oprobst/OvenController/specs/002-controller-pcb/contracts/connectors.md

# Contracts: Steckverbinder, Pinbelegung und Testpunkte (REV A)

Hardware-Schnittstelle zwischen Platine, Lastteil, Bedienteil und Gehäuse (Prinzip VI). Jede
Änderung hier muss in Firmware (`board_rev_a.h`), KiCad-Projekt und Doku nachgezogen werden.
Pin 1 ist auf der Platine markiert.

## J1 – Netz (230 V)

Feste Schraubklemme 2-polig, Raster 5,08 mm (Phoenix MKDS 1,5/2-5,08, Footprint
`oven:Phoenix_MKDS-1,5-2-5.08_Horizontal_OvalPads`). Nur im Netzbereich, Beschriftung „230 V~".

| Pin | Signal |
|---|---|
| 1 | L (nach Hauptschalter und Gerätesicherung der Kaltgerätebuchse) |
| 2 | N |

Kein PE an der Platine. Zuleitung: Mantelleitung H05VV-F 2 × 0,75 mm² durch die Durchführung der
Netzabdeckung (Mantel endet ≥ 5 mm innen, Zugentlastung an der Unterschale); die Klemme
liegt ganz unter der Abdeckung und wird bei offener Abdeckung angeklemmt ([research.md R19](../research.md#r19--netzabdeckung-fr-039-sc-010)).

## J2 – Lastteil (Kleinspannung)

Feste Schraubklemme 6-polig, Raster 3,81 mm (Phoenix MKDS 1/6-3,81, Footprint
`oven:Phoenix_MKDS-1-6-3.81_Horizontal_OvalPads`); Drahteinführung zur Platinenkante.

| Pin | Signal | Gegenstelle |
|---|---|---|
| 1 | +5V_SSR (geschaltet durch Freigabe) | „+" beider SSR-Eingänge |
| 2 | SSR_TOP− | „−" SSR Oberhitze |
| 3 | SSR_BOT− | „−" SSR Unterhitze |
| 4 | +5V (dauernd) | Relaisspule A1 |
| 5 | RELAY− | Relaisspule A2 |
| 6 | GND | Reserve / Schirm |

## J3 – Debug-UART (optional bestückt)

Pinleiste 3-polig: 1 GND, 2 TX (GPIO 43), 3 RX (GPIO 44).

## J4 – Encoder (Encoder-Träger)

JST XH 1×5, Raster 2,5 mm, stehend (B5B-XH-A). Gegenstück gleicher Belegung auf dem Encoder-Träger
(Kabel 1:1). Die Reihenfolge folgt den Anschlüssen des Encoders (A, C, B, S1, S2).

| Pin | Signal | Encoder |
|---|---|---|
| 1 | ENC_A | A |
| 2 | GND | C (gemeinsam) |
| 3 | ENC_B | B |
| 4 | ENC_SW | S1 (Taster) |
| 5 | GND | S2 (Taster) |

Auf dem Encoder-Träger (`hardware/encoder-carrier`): J1 = JST XH 1×5 mit derselben Belegung,
SW1 = Alps EC11E15244G1.

## J5 – Stopp-Taste

JST XH 1×4, Raster 2,5 mm, stehend (B4B-XH-A); die Litzen der Stopp-Taste gehen direkt an die
Hauptplatine (nicht mehr über den Encoder-Träger). Andere Polzahl als J4, damit die Stecker nicht
vertauscht werden können. Ist der Stecker abgezogen, ist der Öffner-Kreis offen und die
Löschleitung aktiv: Ein fehlender Stecker wirkt wie eine gedrückte Stopp-Taste.

| Pin | Signal | Kontakt |
|---|---|---|
| 1 | STOP_NC_OUT (3,3 V zum Öffner) | Öffner, Seite 1 |
| 2 | STOP_NC_RET (vom Öffner zur Löschleitung) | Öffner, Seite 2 |
| 3 | STOP_NO (Schließer → GPIO) | Schließer, Seite 1 |
| 4 | GND | Schließer, Seite 2 |

## J6 – Display

JST XH 1×10, Raster 2,5 mm, stehend (B10B-XH-A), Kabel ≤ 20 cm; die Adern in Pin-Reihenfolge
eng zusammenführen (gern Flachband AWG 28 in XH-Kontakten), damit SCK und MOSI je eine GND-Ader
als Nachbarn behalten.

| Pin | Signal |
|---|---|
| 1 | 3V3 |
| 2 | GND |
| 3 | TFT_SCK |
| 4 | GND |
| 5 | TFT_MOSI |
| 6 | GND |
| 7 | TFT_CS |
| 8 | TFT_DC |
| 9 | TFT_RST |
| 10 | TFT_BL (geschaltete 3,3 V) |

## J7 – USB-C

An der Platinenkante; Panel-Verlängerung zur Gehäusewand.

## J8, J10 – Thermoelemente

Mini-Thermoelement-Buchse Typ K, Print, IEC grün (RS PRO 381-7564, mit Schraube M2,5 auf der
Platine befestigt). J10 = oben, J8 = unten, Polarität (+/−) im Bestückungsdruck.

## J9 – Platinenlüfter

4-poliger Lüfter-Wannenstecker Molex 47053-1000 (2,54 mm, Steg gegen Verpolen), Belegung nach
Intel-4-Draht-Standard; passt direkt zum Stecker des Noctua NF-A4x10 5V PWM
([research.md R18](../research.md#r18--platinenlüfter-fr-036-bis-fr-038)).

| Pin | Signal | Aderfarbe Noctua |
|---|---|---|
| 1 | GND | schwarz |
| 2 | +5V (dauernd) | gelb |
| 3 | FAN_TACH (Open Collector, 2 Pulse/Umdrehung) | grün |
| 4 | FAN_PWM (25 kHz, 5-V-Pegel) | blau |

## Antenne (kein Steckverbinder auf der Platine)

U.FL am Modul (Modulkante), Pigtail zur RP-SMA-Durchführung.

## Pinbelegung ESP32-S3 (REV A)

| Signal | GPIO | Richtung | Beschaltung |
|---|---|---|---|
| REV_STRAP | 1 | ADC | Teiler 10 kΩ / 10 kΩ (1 %) |
| LED_DIAG | 2 | Aus | LED + Vorwiderstand nach GND |
| HEAT_TOP | 4 | Aus | IRLML6346, 100 kΩ Pull-down |
| HEAT_BOT | 5 | Aus | IRLML6346, 100 kΩ Pull-down |
| ARM | 6 | Aus | CLK des Flipflops, 100 kΩ Pull-down |
| TFT_BL | 7 | Aus (PWM) | AO3401A, 100 kΩ Pull-up am Gate |
| TFT_RST | 8 | Aus | |
| TFT_DC | 9 | Aus | |
| TFT_CS | 10 | Aus | 10 kΩ Pull-up |
| TFT_MOSI | 11 | Aus | 33 Ω Serie |
| TFT_SCK | 12 | Aus | 33 Ω Serie |
| TC_MISO | 13 | Ein | |
| TC_SCK | 14 | Aus | |
| TC_MOSI | 15 | Aus | |
| TC_CS_TOP | 16 | Aus | 10 kΩ Pull-up |
| TC_CS_BOT | 17 | Aus | 10 kΩ Pull-up |
| DISARM | 18 | Aus | an /MR TPS3828 (interner Pull-up) |
| USB_D− / USB_D+ | 19 / 20 | USB | USBLC6-2SC6 |
| WDI | 21 | Aus | TPS3828 WDI (Pull-down nach Prüfung R7) |
| BUZZER | 35 | Aus (PWM) | IRLML6346, 100 kΩ Pull-down |
| CLR_SENSE | 36 | Ein | 10 kΩ Serie von der Löschleitung |
| ENC_A / ENC_B / ENC_SW | 39 / 40 / 41 | Ein | 10 kΩ Pull-up, 10 kΩ Serie, 10 nF |
| STOP_NO | 42 | Ein | 10 kΩ Pull-up, 10 kΩ Serie, 10 nF |
| FAN_TACH | 37 | Ein (PCNT) | 10 kΩ Pull-up an 3,3 V, 1 kΩ Serie, 1 nF |
| FAN_PWM | 38 | Aus (PWM, invertiert) | BSS138, 100 kΩ Gate-Pull-down, 1 kΩ Pull-up an +5V am Drain |
| LATCH_Q | 47 | Ein | |
| UART TX / RX | 43 / 44 | – | J3 |
| BOOT | 0 | Ein | Taster nach GND |
| frei | 3, 45, 46, 48 | – | 3, 45, 46 Strapping: nicht beschalten |

## Testpunkte

TP1 GND, TP2 3V3, TP3 5V, TP4 WDI, TP5 ARM, TP6 LATCH_Q, TP7 CLR, TP8 HEAT_TOP, TP9 HEAT_BOT,
TP10 +5V_SSR, TP11 FAN_TACH. Keine Testpunkte im Netzbereich. Der frühere zweite GND-Testpunkt
ist entfallen (Entscheidung des Benutzers 2026-10-30). Alle Referenzen sind nach ihrer Lage im
Schaltplan nummeriert (Neuannotation durch den Benutzer 2026-10-30); Steckverbinder J1–J10,
Testpunkte TP1–TP11.

## Mechanik

- Außenmaße ≤ 150 × 150 mm, Ziel ≤ 100 × 100 mm; Bauteilhöhe ≤ 40 mm (höchstes Teil
  IRM-10-5).
- 4 Montagelöcher M3 ohne Kupfer, Lage wird mit dem Feature „Controller-Gehäuse" abgestimmt
  (Übergabe als STEP und Maßzeichnung).
- Netzabdeckung (Footprint COV1): Ober- und Unterschale über dem Netzbereich, befestigt an
  H5–H8 (Ø 3,2 mm, ohne Kupfer, ≥ 6 mm vom Netzkupfer). Bauraum: ca. 27 mm über und 6 mm unter
  der Platine, ca. 3 mm Überstand am linken und unteren Rand. Liegen H1/H3 im Abdeckbereich,
  führen geschlossene Hülsen der Schalen die Befestigungsschrauben. Bauteile unter dem Deckel
  ≤ 25 mm hoch; unter der Innenwand keine Bauteile.
