oprobst/OvenController/specs/002-controller-pcb/checklists/requirements.md

# Specification Quality Checklist: Controller-Platine (PCB REV A)

**Purpose**: Validate specification completeness and quality before proceeding to planning
**Created**: 2026-10-25
**Feature**: [spec.md](../spec.md)

## Content Quality

- [x] No implementation details (languages, frameworks, APIs)
- [x] Focused on user value and business needs
- [x] Written for non-technical stakeholders
- [x] All mandatory sections completed

## Requirement Completeness

- [x] No [NEEDS CLARIFICATION] markers remain
- [x] Requirements are testable and unambiguous
- [x] Success criteria are measurable
- [x] Success criteria are technology-agnostic (no implementation details)
- [x] All acceptance scenarios are defined
- [x] Edge cases are identified
- [x] Scope is clearly bounded
- [x] Dependencies and assumptions identified

## Feature Readiness

- [x] All functional requirements have clear acceptance criteria
- [x] User scenarios cover primary flows
- [x] Feature meets measurable outcomes defined in Success Criteria
- [x] No implementation details leak into specification

## Notes

- Das Feature ist selbst Hardware. Funktionsbegriffe wie Halbleiterrelais, Sicherheitsrelais,
  Thermoelement Typ K, Netzteilmodul und KiCad sind Anforderungen aus der Verfassung bzw.
  getroffene Systementscheidungen, keine Implementierungsdetails. Konkrete Bauteile,
  Teilenummern und Pinbelegung stehen bewusst nicht in der Spezifikation, sondern in
  `docs/hardware-umbau.md` als Eingabe für den Plan.
- „Nicht-technische Leser": Zielgruppe ist der Projektverantwortliche; die Szenarien sind als
  Bedien- und Prüfabläufe formuliert.
- Ohne Rückfrage festgelegt (siehe Assumptions): PCB-Grenzwerte 60 °C (Firmware) und 65 °C
  (Hardware), Handbestückung, Firmware-Anpassungen für REV A gehören zum Feature.
- Validierung in einer Iteration bestanden.
