oprobst/OvenController/docs/compatibility.md

# Kompatibilitätsmatrix

Welche Firmware-Version passt zu welcher PCB- und Gehäuse-Revision (Constitution, Prinzip VI).
Bei jedem Firmware-Release und jeder neuen Revision aktualisieren, ebenso das Ergebnis der
HIL-Tests und der Abnahme (Prinzip III).

| Firmware | PCB-Revision | Gehäuse-Revision | HIL-Tests | Abnahme (quickstart) | Bemerkung |
|---|---|---|---|---|---|
| 0.1.0 | DEV (Steckbrett, ESP32-DevKitC V4) | – | offen | offen | Feature 001: Begrüßung, Statusanzeige, Hauptmenü; keine Heizungsansteuerung |
