oprobst/OvenController/specs/001-startup-status-menu/checklists/requirements.md

# Specification Quality Checklist: Startbildschirm mit Statusanzeige und Hauptmenü

**Purpose**: Validate specification completeness and quality before proceeding to planning
**Created**: 2026-10-24
**Feature**: [spec.md](../spec.md)

## Content Quality

- [x] No implementation details (languages, frameworks, APIs)
- [x] Focused on user value and business needs
- [x] Written for non-technical stakeholders
- [x] All mandatory sections completed

## Requirement Completeness

- [x] No [NEEDS CLARIFICATION] markers remain
- [x] Requirements are testable and unambiguous
- [x] Success criteria are measurable
- [x] Success criteria are technology-agnostic (no implementation details)
- [x] All acceptance scenarios are defined
- [x] Edge cases are identified
- [x] Scope is clearly bounded
- [x] Dependencies and assumptions identified

## Feature Readiness

- [x] All functional requirements have clear acceptance criteria
- [x] User scenarios cover primary flows
- [x] Feature meets measurable outcomes defined in Success Criteria
- [x] No implementation details leak into specification

## Notes

- Beide Klärungen am 2026-10-24 beantwortet (FR-011: Platzhalter „Heizen", „Profil",
  „Setup" ohne Wirkung; FR-013: Zugangsdaten zur Build-Zeit aus lokaler Datei). Alle Punkte
  bestanden.
- Hardware-Bezüge (Drehencoder, Thermoelement) stammen aus der Vorauswahl in `docs/` und sind
  als Annahmen markiert; die konkrete Bauteilwahl erfolgt im Plan.
- Items marked incomplete require spec updates before `/speckit-clarify` or `/speckit-plan`
