oprobst/OvenController/hardware/controller/controller.kicad_pcb

## KiCad design hardware/controller/controller.kicad_pcb (2026-10-30)

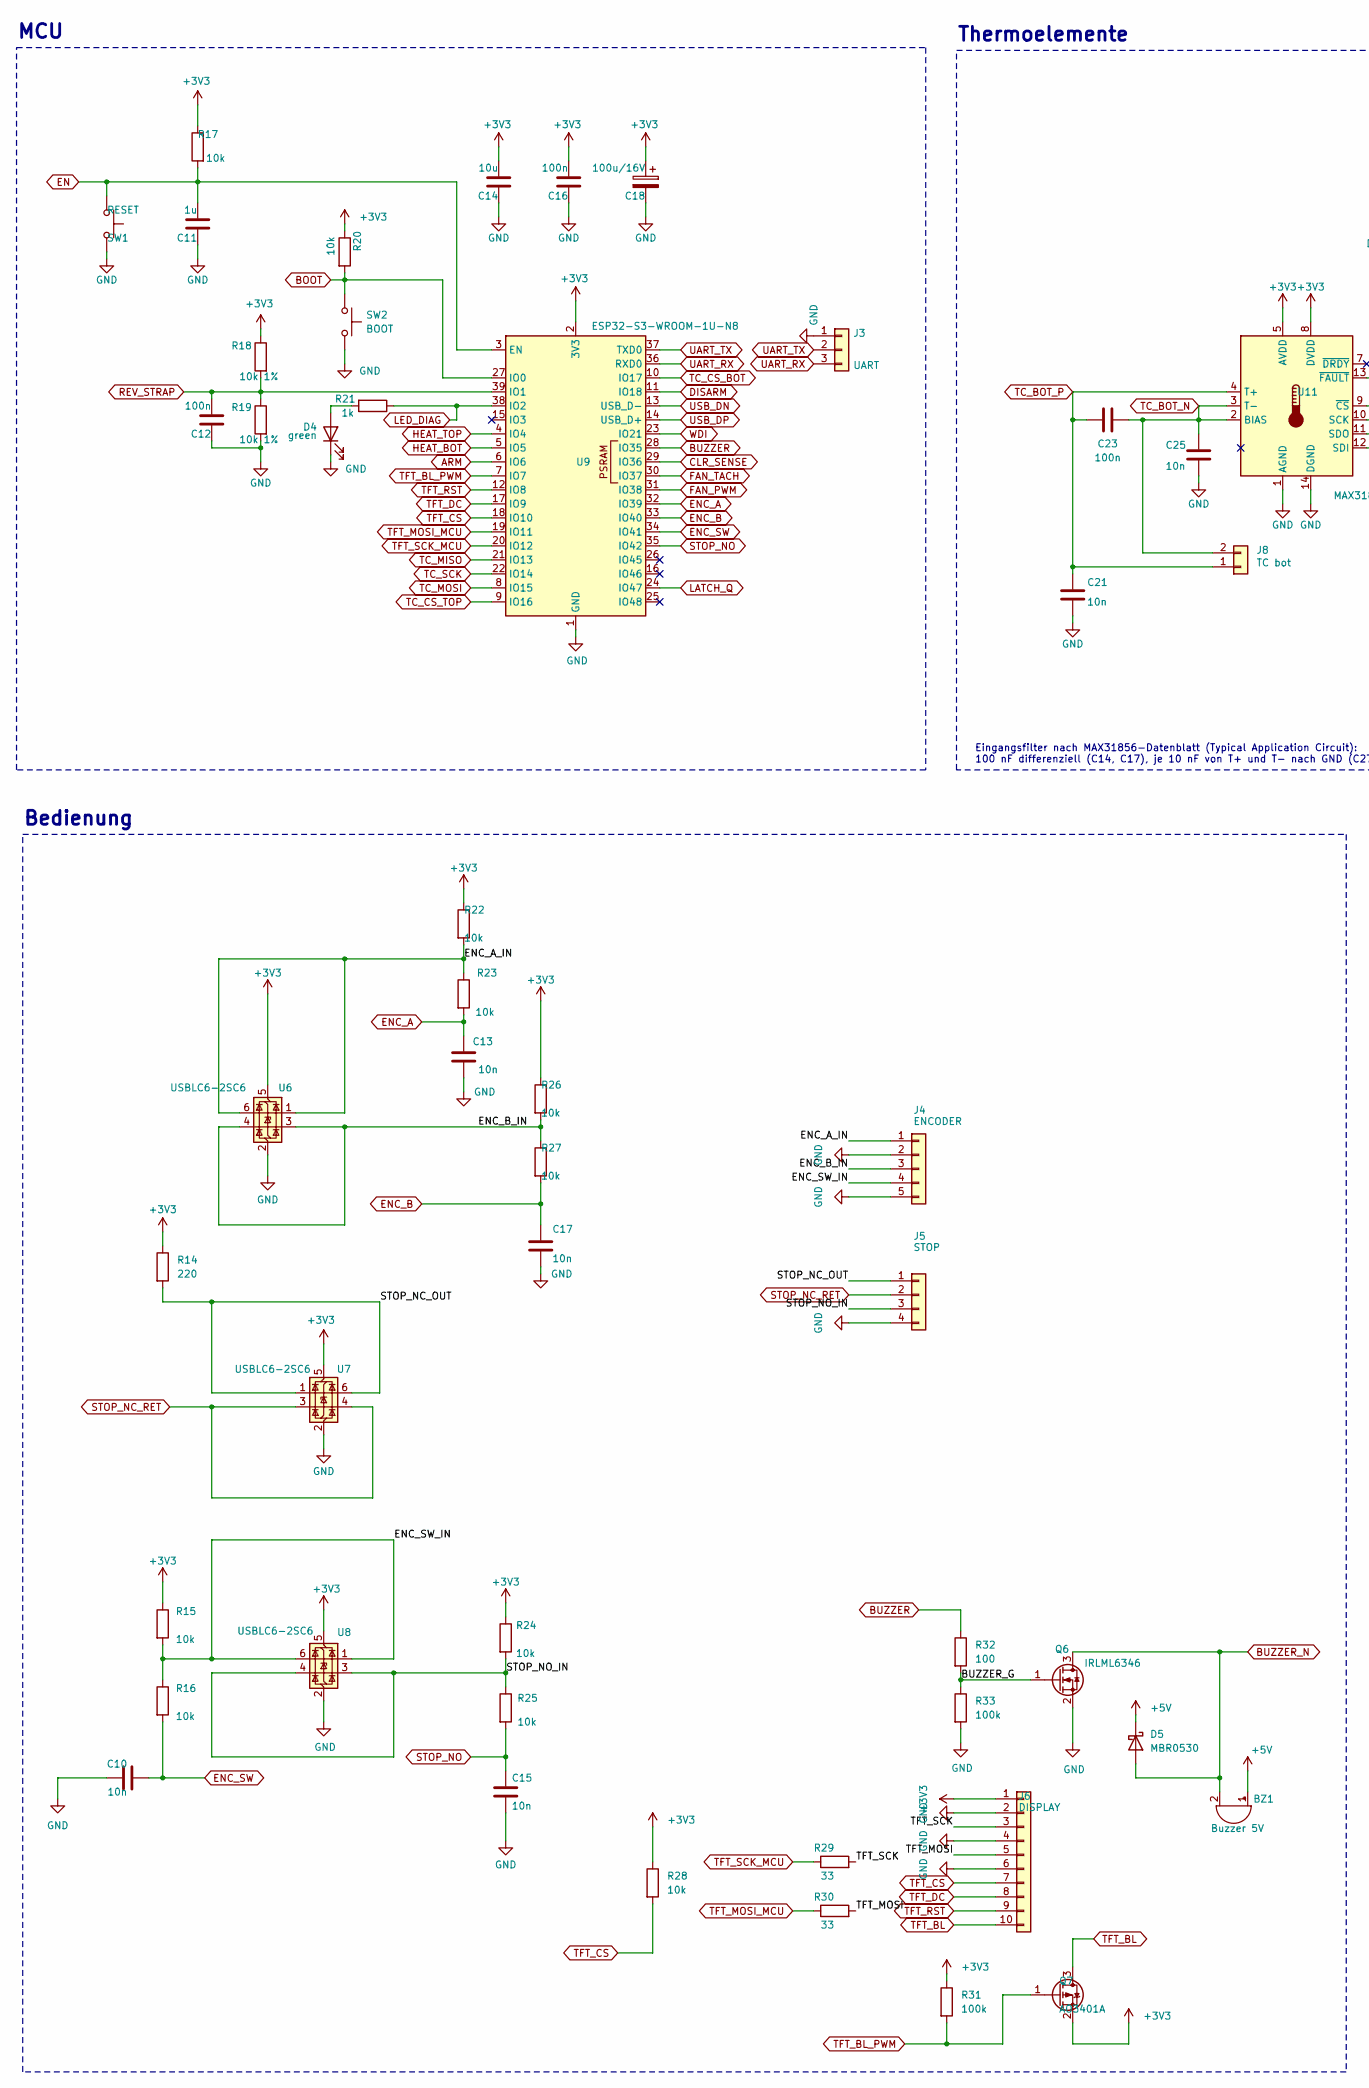
[picture p1: schematic controller_steuerung.kicad_sch, Controller REV A, part in row 1, column 1]

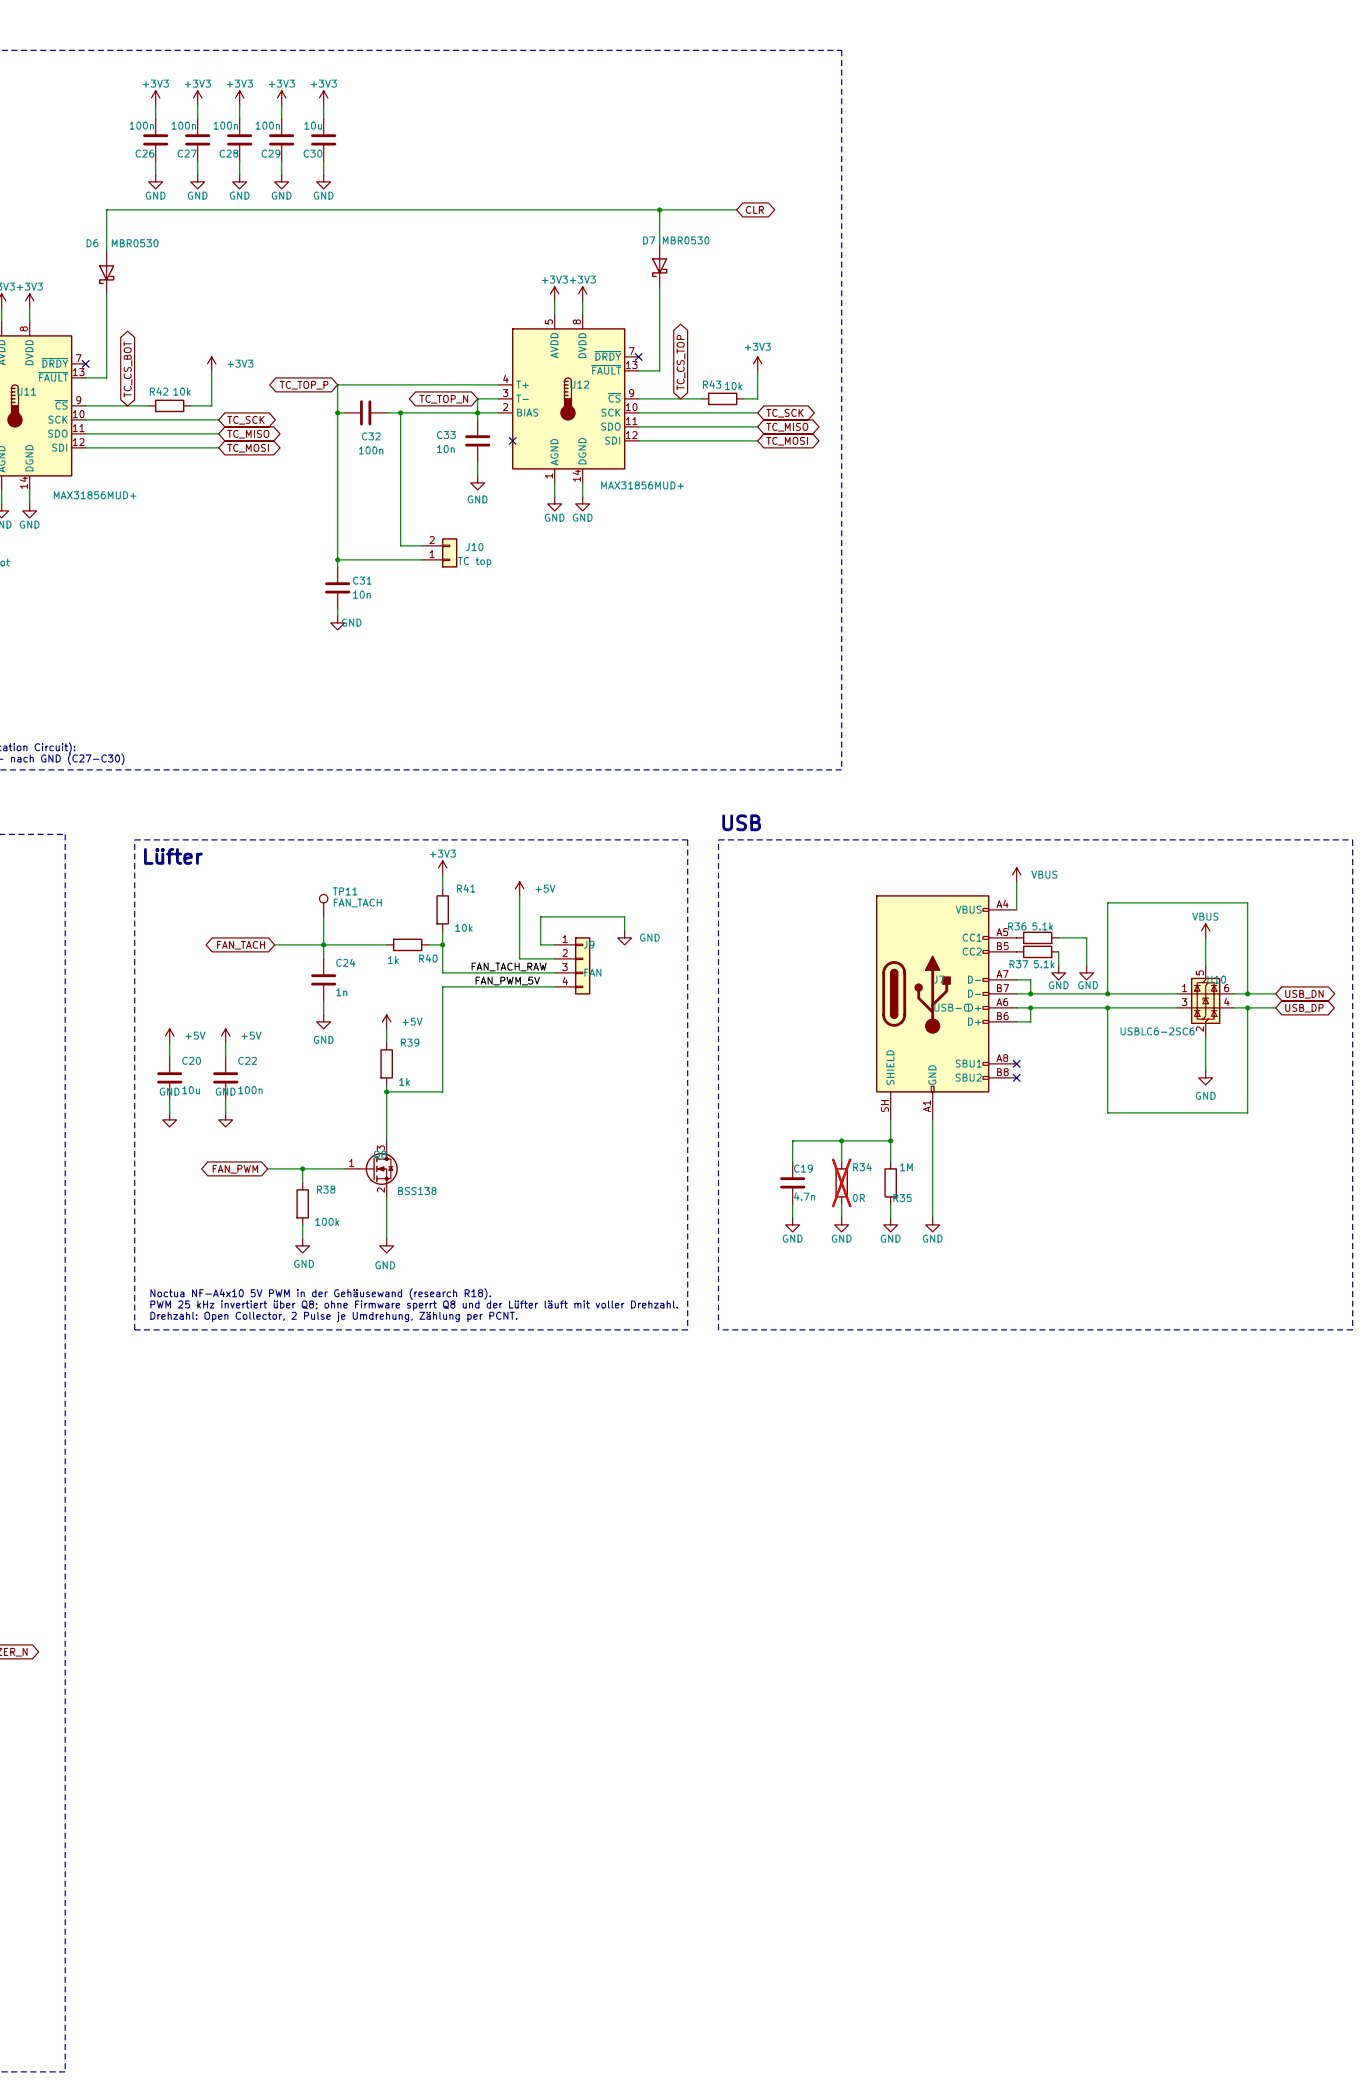
[picture p2: schematic controller_steuerung.kicad_sch, Controller REV A, part in row 1, column 2]

Parts:
BZ1: Buzzer 5V; Buzzer_12x9.5RM7.6; MPN passive magnetic 5 V, >= 70 °C (tbd)
C10, C13, C15, C17, C21, C25, C31, C33: 10n; C_0603_1608Metric
C11: 1u; C_0603_1608Metric
C12, C16, C22, C23, C26, C27, C28, C29, C32: 100n; C_0603_1608Metric
C14, C20, C30: 10u; C_0805_2012Metric
C18: 100u/16V; CP_Radial_D6.3mm_P2.50mm; MPN 105 °C type
C19: 4.7n; C_0603_1608Metric
C24: 1n; C_0603_1608Metric
D4: green; LED_0805_2012Metric
D5, D6, D7: MBR0530; D_SOD-123
J3: UART; PinHeader_1x03_P2.54mm_Vertical
J4: ENCODER; JST_XH_B5B-XH-A_1x05_P2.50mm_Vertical; MPN JST B5B-XH-A
J5: STOP; JST_XH_B4B-XH-A_1x04_P2.50mm_Vertical; MPN JST B4B-XH-A
J6: DISPLAY; JST_XH_B10B-XH-A_1x10_P2.50mm_Vertical; MPN JST B10B-XH-A
J7: USB-C; USB_C_Receptacle_GCT_USB4085; MPN GCT USB4085-GF-A
J8: TC bot; RS_381-7564_Horizontal; MPN RS PRO 381-7564
J9: FAN; FanPinHeader_1x04_P2.54mm_Vertical
J10: TC top; RS_381-7564_Horizontal; MPN RS PRO 381-7564
Q6: IRLML6346; SOT-23; MPN IRLML6346
Q7: AO3401A; SOT-23; MPN AO3401A
Q8: BSS138; SOT-23; MPN BSS138
R14: 220; R_0603_1608Metric
R15, R16, R17, R20, R22, R23, R24, R25, R26, R27, R28, R41, R42, R43: 10k; R_0603_1608Metric
R18, R19: 10k 1%; R_0603_1608Metric
R21, R39, R40: 1k; R_0603_1608Metric
R29, R30: 33; R_0603_1608Metric
R31, R33, R38: 100k; R_0603_1608Metric
R32: 100; R_0603_1608Metric
R34: 0R; R_0603_1608Metric; not fitted
R35: 1M; R_0603_1608Metric
R36, R37: 5.1k; R_0603_1608Metric
SW1: RESET; SW_PUSH_6mm
SW2: BOOT; SW_PUSH_6mm
TP11: FAN_TACH; TestPoint_Keystone_5000-5004_Miniature
U6, U7, U8, U10: USBLC6-2SC6; SOT-23-6; MPN ST USBLC6-2SC6
U9: ESP32-S3-WROOM-1U-N8; ESP32-S3-WROOM-1U; MPN Espressif ESP32-S3-WROOM-1U-N8
U11, U12: MAX31856MUD+; TSSOP-14_4.4x5mm_P0.65mm; MPN Analog Devices MAX31856MUD+

Connections:
+3V3: C14.1, C16.1, C18.1, C26.1, C27.1, C28.1, C29.1, C30.1, J6.1, Q7.2 (S), R14.1, R15.1, R17.1, R18.1, R20.1, R22.1, R24.1, R26.1, R28.1, R31.1, R41.1, R42.1, R43.1, U6.5 (VBUS), U7.5 (VBUS), U8.5 (VBUS), U9.2 (3V3), U11.5 (AVDD), U11.8 (DVDD), U12.5 (AVDD), U12.8 (DVDD); also elsewhere on the board
+5V: BZ1.1 (+), C20.1, C22.1, D5.1 (K), J9.2, R39.1; also elsewhere on the board
/Steuerung und Messung/BUZZER_G: Q6.1 (G), R32.2, R33.1
/Steuerung und Messung/ENC_A_IN: J4.1, R22.2, R23.1, U6.1 (I/O1), U6.6 (I/O1)
/Steuerung und Messung/ENC_B_IN: J4.3, R26.2, R27.1, U6.3 (I/O2), U6.4 (I/O2)
/Steuerung und Messung/ENC_SW_IN: J4.4, R15.2, R16.1, U8.1 (I/O1), U8.6 (I/O1)
/Steuerung und Messung/FAN_PWM_5V: J9.4, Q8.3 (D), R39.2
/Steuerung und Messung/FAN_TACH_RAW: J9.3, R40.1, R41.2
/Steuerung und Messung/STOP_NC_OUT: J5.1, R14.2, U7.1 (I/O1), U7.6 (I/O1)
/Steuerung und Messung/STOP_NO_IN: J5.3, R24.2, R25.1, U8.3 (I/O2), U8.4 (I/O2)
/Steuerung und Messung/TFT_MOSI: J6.5, R30.2
/Steuerung und Messung/TFT_SCK: J6.3, R29.2
ARM: U9.6 (IO6); also elsewhere on the board
BOOT: R20.2, SW2.1, U9.27 (IO0)
BUZZER: R32.1, U9.28 (IO35)
BUZZER_N: BZ1.2 (-), D5.2 (A), Q6.3 (D)
CLR: D6.2 (A), D7.2 (A); also elsewhere on the board
CLR_SENSE: U9.29 (IO36); also elsewhere on the board
DISARM: U9.11 (IO18); also elsewhere on the board
EN: C11.1, R17.2, SW1.1, U9.3 (EN)
ENC_A: C13.1, R23.2, U9.32 (IO39)
ENC_B: C17.1, R27.2, U9.33 (IO40)
ENC_SW: C10.1, R16.2, U9.34 (IO41)
FAN_PWM: Q8.1 (G), R38.1, U9.31 (IO38)
FAN_TACH: C24.1, R40.2, TP11.1 (1_1), U9.30 (IO37)
GND: C10.2, C11.2, C12.2, C13.2, C14.2, C15.2, C16.2, C17.2, C18.2, C19.2, C20.2, C21.2, C22.2, C24.2, C25.2, C26.2, C27.2, C28.2, C29.2, C30.2, C31.2, C33.2, D4.1 (K), J3.1, J4.2, J4.5, J5.4, J6.2, J6.4, J6.6, J7.A1 (GND), J7.A12 (GND), J7.B1 (GND), J7.B12 (GND), J9.1, Q6.2 (S), Q8.2 (S), R19.2, R33.2, R34.2, R35.2, R36.2, R37.2, R38.2, SW1.2, SW2.2, U6.2 (GND), U7.2 (GND), U8.2 (GND), U9.1 (GND), U9.40 (GND), U9.41 (GND), U10.2 (GND), U11.1 (AGND), U11.14 (DGND), U12.1 (AGND), U12.14 (DGND); also elsewhere on the board
HEAT_BOT: U9.5 (IO5); also elsewhere on the board
HEAT_TOP: U9.4 (IO4); also elsewhere on the board
LATCH_Q: U9.24 (IO47); also elsewhere on the board
LED_DIAG: R21.1, U9.38 (IO2)
unnamed: D4.2 (A), R21.2
unnamed: D6.1 (K), U11.13 (~FAULT)
unnamed: D7.1 (K), U12.13 (~FAULT)
unnamed: J7.A5 (CC1), R36.1
unnamed: J7.B5 (CC2), R37.1
unnamed: C19.1, J7.SH (SHIELD), R34.1, R35.1
REV_STRAP: C12.1, R18.2, R19.1, U9.39 (IO1)
STOP_NC_RET: J5.2, U7.3 (I/O2), U7.4 (I/O2); also elsewhere on the board
STOP_NO: C15.1, R25.2, U9.35 (IO42)
TC_BOT_N: C23.2, C25.1, J8.2, U11.2 (BIAS), U11.3 (T-)
TC_BOT_P: C21.1, C23.1, J8.1, U11.4 (T+)
TC_CS_BOT: R42.2, U9.10 (IO17), U11.9 (~CS)
TC_CS_TOP: R43.2, U9.9 (IO16), U12.9 (~CS)
TC_MISO: U9.21 (IO13), U11.11 (SDO), U12.11 (SDO)
TC_MOSI: U9.8 (IO15), U11.12 (SDI), U12.12 (SDI)
TC_SCK: U9.22 (IO14), U11.10 (SCK), U12.10 (SCK)
TC_TOP_N: C32.2, C33.1, J10.2, U12.2 (BIAS), U12.3 (T-)
TC_TOP_P: C31.1, C32.1, J10.1, U12.4 (T+)
TFT_BL: J6.10, Q7.3 (D)
TFT_BL_PWM: Q7.1 (G), R31.2, U9.7 (IO7)
TFT_CS: J6.7, R28.2, U9.18 (IO10)
TFT_DC: J6.8, U9.17 (IO9)
TFT_MOSI_MCU: R30.1, U9.19 (IO11)
TFT_RST: J6.9, U9.12 (IO8)
TFT_SCK_MCU: R29.1, U9.20 (IO12)
UART_RX: J3.3, U9.36 (RXD0)
UART_TX: J3.2, U9.37 (TXD0)
USB_DN: J7.A7 (D-), J7.B7 (D-), U9.13 (USB_D-), U10.1 (I/O1), U10.6 (I/O1)
USB_DP: J7.A6 (D+), J7.B6 (D+), U9.14 (USB_D+), U10.3 (I/O2), U10.4 (I/O2)
VBUS: J7.A4 (VBUS), J7.A9 (VBUS), J7.B4 (VBUS), J7.B9 (VBUS), U10.5 (VBUS); also elsewhere on the board
WDI: U9.23 (IO21); also elsewhere on the board

Notes on the sheet:
Noctua NF-A4x10 5V PWM in der Gehäusewand (research R18). PWM 25 kHz invertiert über Q8; ohne Firmware sperrt Q8 und der Lüfter läuft mit voller Drehzahl. Drehzahl: Open Collector, 2 Pulse je Umdrehung, Zählung per PCNT.
Eingangsfilter nach MAX31856-Datenblatt (Typical Application Circuit): 100 nF differenziell (C14, C17), je 10 nF von T+ und T- nach GND (C27-C30)
Thermoelemente
Lüfter
Bedienung
USB
MCU

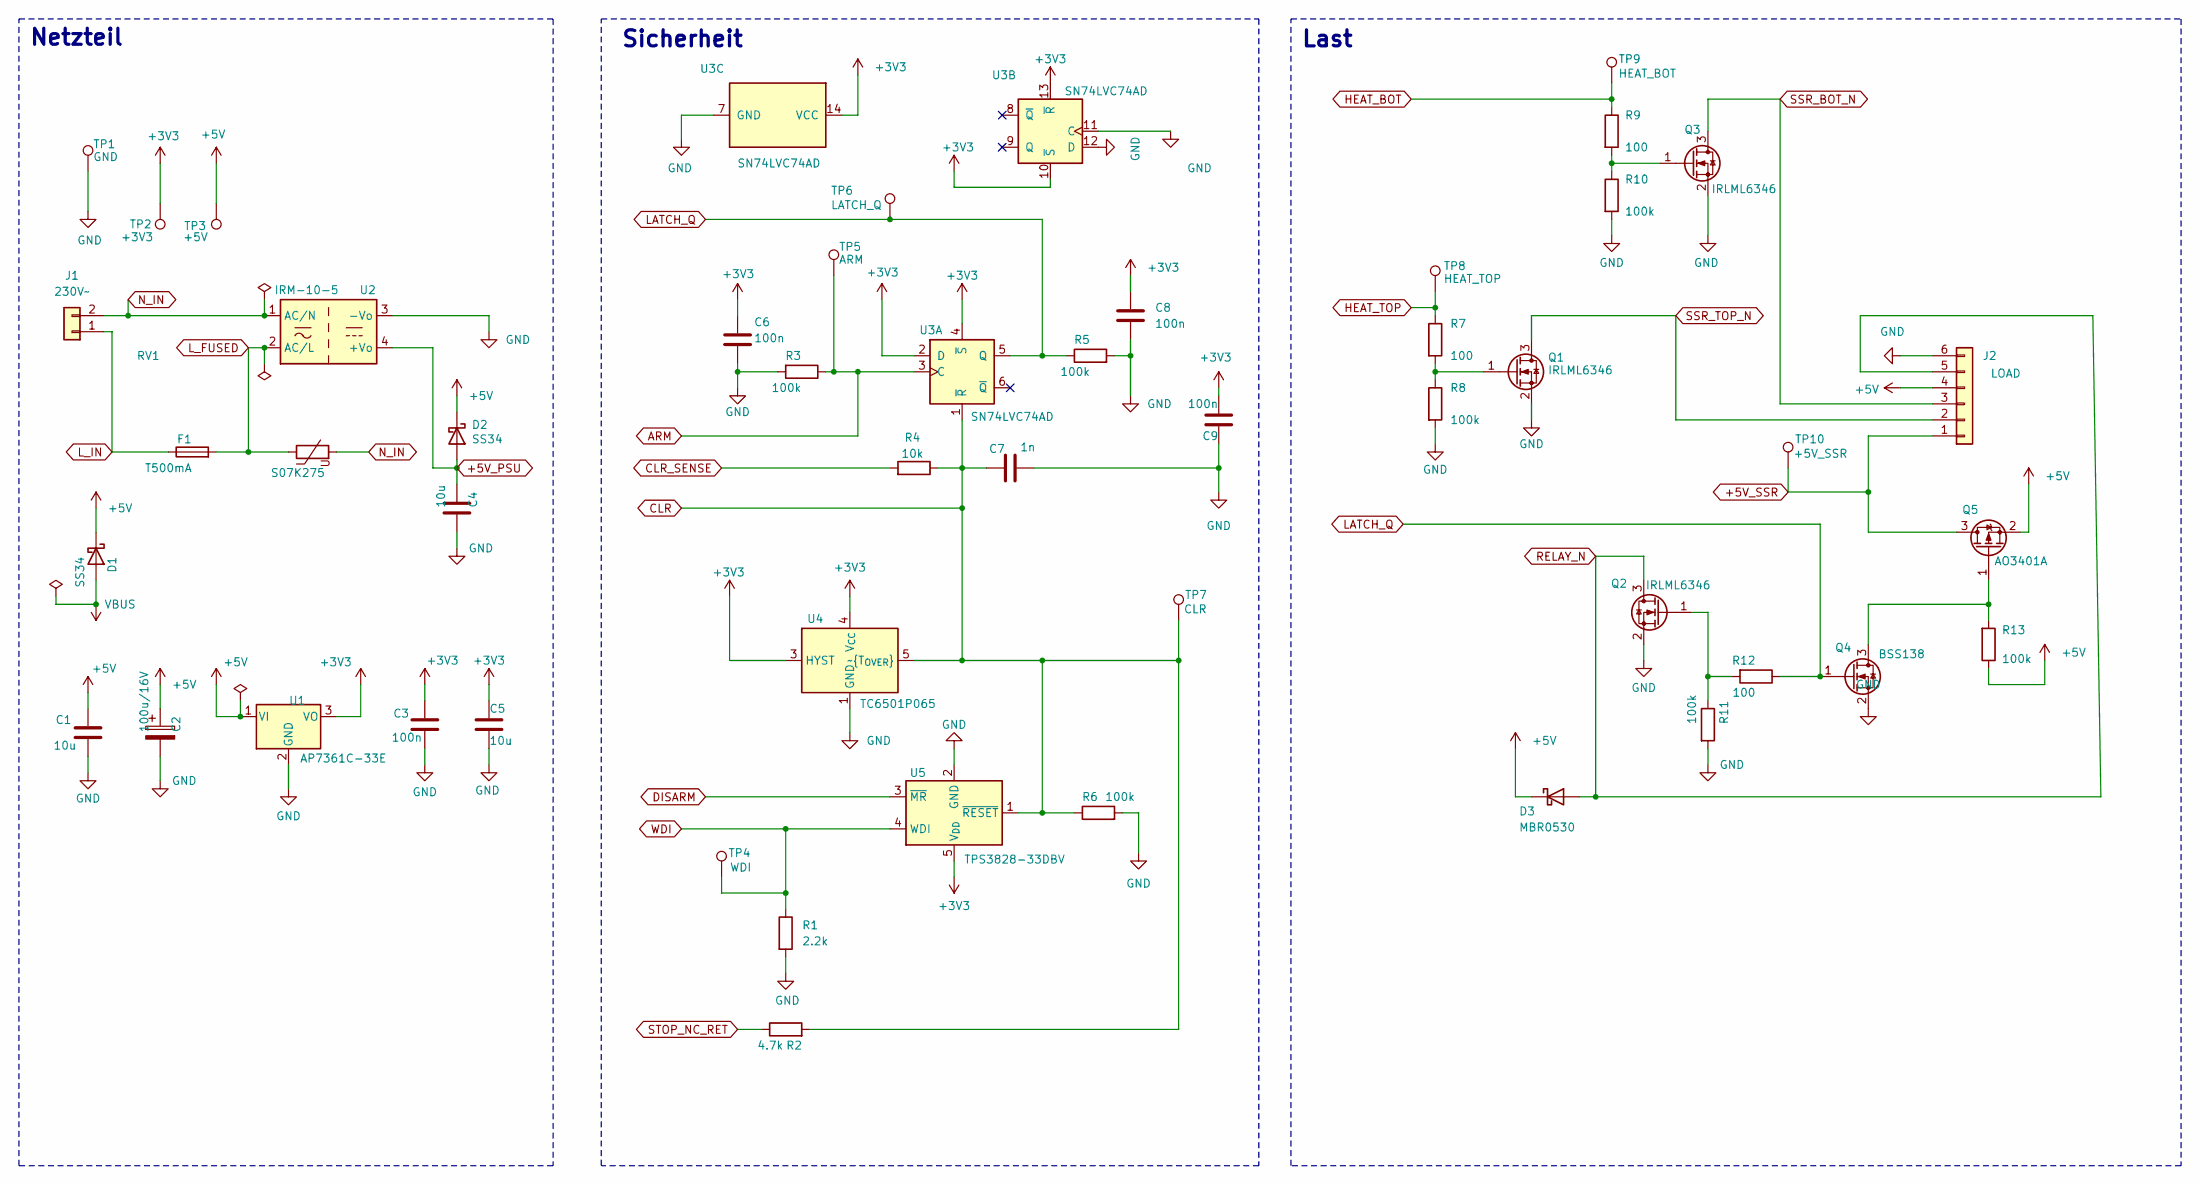
[picture p3: schematic controller_leistung.kicad_sch, Controller REV A]

Parts:
C1, C4, C5: 10u; C_0805_2012Metric
C2: 100u/16V; CP_Radial_D6.3mm_P2.50mm; MPN 105 °C type
C3, C6, C8, C9: 100n; C_0603_1608Metric
C7: 1n; C_0603_1608Metric
D1, D2: SS34; D_SMA
D3: MBR0530; D_SOD-123
F1: T500mA; Fuseholder_Cylinder-5x20mm_Schurter_0031_8201_Horizontal_Op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; MPN Schurter OGN 0031.8201 + 5x20 T500mA
J1: 230V~; Phoenix_MKDS-1,5-2-5.08_Horizontal_OvalPads; MPN Phoenix MKDS 1,5/2-5,08
J2: LOAD; Phoenix_MKDS-1-6-3.81_Horizontal_OvalPads; MPN Phoenix MKDS 1/6-3,81
Q1, Q2, Q3: IRLML6346; SOT-23; MPN IRLML6346
Q4: BSS138; SOT-23; MPN BSS138
Q5: AO3401A; SOT-23; MPN AO3401A
R1: 2.2k; R_0603_1608Metric
R2: 4.7k; R_0603_1608Metric
R3, R5, R6, R8, R10, R11, R13: 100k; R_0603_1608Metric
R4: 10k; R_0603_1608Metric
R7, R9, R12: 100; R_0603_1608Metric
RV1: S07K275; RV_Disc_D7mm_W3.4mm_P5mm; MPN TDK B72207S2271K101
TP1: GND; TestPoint_Keystone_5000-5004_Miniature
TP2: +3V3; TestPoint_Keystone_5000-5004_Miniature
TP3: +5V; TestPoint_Keystone_5000-5004_Miniature
TP4: WDI; TestPoint_Keystone_5000-5004_Miniature
TP5: ARM; TestPoint_Keystone_5000-5004_Miniature
TP6: LATCH_Q; TestPoint_Keystone_5000-5004_Miniature
TP7: CLR; TestPoint_Keystone_5000-5004_Miniature
TP8: HEAT_TOP; TestPoint_Keystone_5000-5004_Miniature
TP9: HEAT_BOT; TestPoint_Keystone_5000-5004_Miniature
TP10: +5V_SSR; TestPoint_Keystone_5000-5004_Miniature
U1: AP7361C-33E; SOT-223-3_TabPin2; MPN Diodes AP7361C-33E-13
U2: IRM-10-5; Converter_ACDC_MeanWell_IRM-10-xx_THT; MPN Mean Well IRM-10-5
U3: SN74LVC74AD; SOIC-14_3.9x8.7mm_P1.27mm; MPN TI SN74LVC74AD
U4: TC6501P065; SOT-23-5; MPN Microchip TC6501P065VCTTR
U5: TPS3828-33DBV; SOT-23-5; MPN TI TPS3828-33DBVR

Connections:
+3V3: C3.1, C5.1, C6.1, C8.1, C9.1, TP2.1 (1_1), U1.3 (VO), U3.2 (D), U3.4 (~S), U3.10 (~S), U3.13 (~R), U3.14 (VCC), U4.3 (HYST), U4.4 (V_{CC}), U5.5 (V_{DD}); also elsewhere on the board
+5V: C1.1, C2.1, D1.1 (K), D2.1 (K), D3.1 (K), J2.4, Q5.2 (S), R13.1, TP3.1 (1_1), U1.1 (VI); also elsewhere on the board
+5V_PSU: C4.1, D2.2 (A), U2.4 (+Vo)
+5V_SSR: J2.1, Q5.3 (D), TP10.1 (1_1)
ARM: R3.1, TP5.1 (1_1), U3.3 (C); also elsewhere on the board
CLR: C7.1, R2.2, R4.1, R6.1, TP7.1 (1_1), U3.1 (~R), U4.5 (~T_{OVER}), U5.1 (~RESET); also elsewhere on the board
CLR_SENSE: R4.2; also elsewhere on the board
DISARM: U5.3 (~MR); also elsewhere on the board
GND: C1.2, C2.2, C3.2, C4.2, C5.2, C6.2, C7.2, C8.2, C9.2, J2.6, Q1.2 (S), Q2.2 (S), Q3.2 (S), Q4.2 (S), R1.2, R3.2, R5.2, R6.2, R8.2, R10.2, R11.2, TP1.1 (1_1), U1.2 (GND), U2.3 (-Vo), U3.7 (GND), U3.11 (C), U3.12 (D), U4.1 (GND), U4.2 (GND), U5.2 (GND); also elsewhere on the board
HEAT_BOT: R9.1, TP9.1 (1_1); also elsewhere on the board
HEAT_TOP: R7.1, TP8.1 (1_1); also elsewhere on the board
LATCH_Q: Q4.1 (G), R5.1, R12.1, TP6.1 (1_1), U3.5 (Q); also elsewhere on the board
L_FUSED: F1.2, RV1.1, U2.2 (AC/L)
L_IN: F1.1, J1.1
N_IN: J1.2, RV1.2, U2.1 (AC/N)
unnamed: Q1.1 (G), R7.2, R8.1
unnamed: Q2.1 (G), R11.1, R12.2
unnamed: Q3.1 (G), R9.2, R10.1
unnamed: Q4.3 (D), Q5.1 (G), R13.2
RELAY_N: D3.2 (A), J2.5, Q2.3 (D)
SSR_BOT_N: J2.3, Q3.3 (D)
SSR_TOP_N: J2.2, Q1.3 (D)
STOP_NC_RET: R2.1; also elsewhere on the board
VBUS: D1.2 (A); also elsewhere on the board
WDI: R1.1, TP4.1 (1_1), U5.4 (WDI); also elsewhere on the board

Notes on the sheet:
Netzteil
Last
Sicherheit

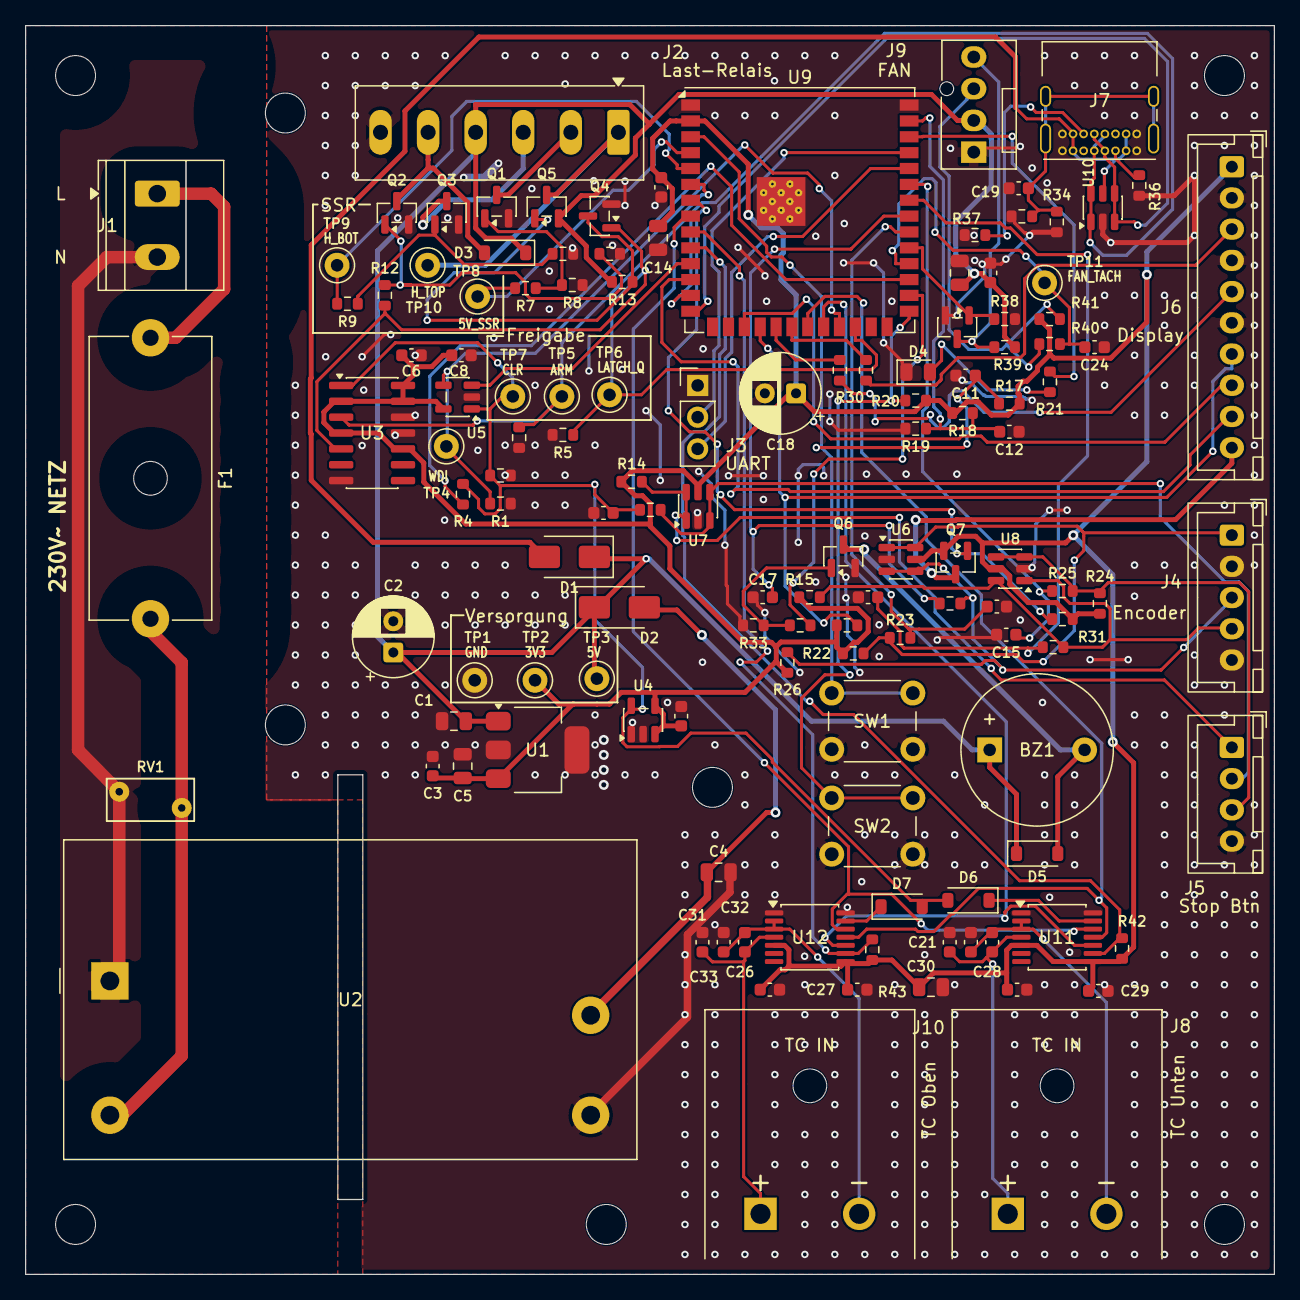
[picture p4: board controller.kicad_pcb from above]

Board: 2 copper layers, 100.0 x 100.0 mm, 134 parts (0 on the bottom side), 73 nets.

Other parts of the board:
COV1: Netzabdeckung_REVA
H1, H2, H3, H4: MountingHole_3.2mm_M3
