oprobst/OvenController/(commit log)

2026-10-24 Initiales Projekt-Setup mit Spec Kit und Hardware-Doku
    - Spec Kit (specify-cli 1.2.4) mit Claude-Integration und PowerShell-Skripten
    - docs/: Hardware-Umbau, Umluft-Recherche, PCB-Werkzeuge, Anwendungshinweise
    - CLAUDE.md mit Verweis auf die Projekt-Doku
2026-10-24 docs: ratify project constitution v1.6.0
    Add the Spec Kit setup and the Mini-Ofen-Controller constitution
    (principles I-X: modular SOLID firmware, HAL & tests, thermal/electrical
    safety, determinism, revision consistency, configuration, state machine,
    diagnostics, thermal enclosure design).
2026-10-24 docs: amend constitution to v1.7.0 (PCB over-temperature shutdown in principle IV)
2026-10-24 docs: amend constitution to v1.8.0 (split safety principle, power-on/default-off/max runtime rules, solo-review governance)
2026-10-24 docs: add spec 001-startup-status-menu (welcome screen, status, main menu)
    Spec for the first feature: welcome screen with firmware version and PCB
    revision, WiFi status with time/date, oven temperature, and a main menu
    with placeholder entries (Heizen, Profil, Setup). Includes resolved
    clarifications and the requirements quality checklist.
2026-10-24 docs: add plan and tasks for 001-startup-status-menu, define control panel
    Plan, research, data model, contracts (interfaces, UI screens, log
    format), quickstart and tasks for the first firmware feature on the
    ESP32-DevKitC V4 with a 2.8" ST7789 TFT in portrait orientation.
    docs/hardware-umbau.md: control panel dimensions and the chosen input
    concept (TFT, rotary encoder with push button, separate stop button).
2026-10-24 feat(firmware): implement 001-startup-status-menu (welcome, status, main menu)
    First firmware for the ESP32-DevKitC V4 (PCB REV DEV) with a 2.8" ST7789
    TFT in portrait orientation:
    - welcome screen with firmware version and PCB revision
    - two-row status area: WiFi state, SNTP time/date (CET/CEST), oven
    temperature from the MAX31855 or sensor fault code (E101-E105)
    - main menu with placeholder entries Heizen, Profil, Setup, operated by
    the rotary encoder; selection only logs
    - explicit UI state machine, non-blocking scheduler, structured logging,
    task watchdog; no heater output is driven
    Modular PlatformIO libraries with HAL in hal_esp32, 92 host tests
    (Unity), HIL tests for MAX31855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
2026-10-24 docs: define controller hardware (load side, power, sensors, MCU pinout)
    - Encoder: Alps EC11E15244G1, panel mount; divisor per board revision
    - Load side: panel SSRs, Finder 40.61 safety relay, enable latch with
    stop NC contact, TC6501, MAX31856 FAULT and TPS3828 watchdog
    - Power: Mean Well IRM-10-5, AP7361C-33 LDO, current budget
    - Sensors: 2x MAX31856 (top/bottom), CJ as PCB temperature
    - MCU: switch to ESP32-S3-WROOM-1-N8 with native USB, pinout REV A draft
    - No convection fan; debug LED on the board
2026-10-25 docs: add spec and plan for 002-controller-pcb, finalize hardware decisions
    - Spec 002 (PCB REV A) with clarifications: hand assembly, max 150x150 mm,
    PCB limits 60/65 degC, no 230 V test points, bring-up firmware in scope
    - Plan, research (R1-R17), data model, contracts (interfaces, connectors),
    quickstart for bring-up/HIL
    - Toolchain: SKiDL + KiCad 10.0.3
    - hardware-umbau: S3 pin check against datasheet, CLR line fix, layout and
    connectors, inventory comparison, ESP32-S3-WROOM-1U-N8, CLR_SENSE pin
2026-10-25 docs: add tasks for 002-controller-pcb
2026-10-25 feat(hardware): phase 1 setup for 002-controller-pcb
    - hardware/ skeleton, README with toolchain and kicad-cli commands
    - SKiDL 3.0.0 pinned; spike confirms KICAD10 support and netlist import
    - PlatformIO env esp32s3_reva and board_rev_a.h (CI build follows with T044)
2026-10-25 docs: datasheet checks and part selection for 002 (T006-T008)
    - TPS3828: watchdog 0.9/1.6/2.5 s -> SC-002 now 2.6 s; floating WDI
    disables the watchdog -> 2.2k pull-down; CLR series resistor 4.7k
    - Relay Finder 40.61.9.005 (pick-up 3.65 V), SSR Crydom D2425
    - Parts list with manufacturer numbers and KiCad 10 footprints
2026-10-25 feat(hardware): part library and datasheet check list (T009)
    - oven.kicad_sym: TC6501, TPS3828-33DBV (open-drain reset)
    - oven.pretty: Omega PCC-SMP footprint (axial spacing still to be measured)
    - lib/README.md: pinout checks for all main parts against datasheets
    - MAX31856 FAULT outputs join the clear line through Schottky diodes
2026-10-25 feat(hardware): schematic blocks for controller REV A (T010-T016)
    - SKiDL blocks: power, mcu, usb, thermocouple, safety, load, ui + common helpers
    - 115 parts, 70 nets, SKiDL ERC clean
    - Corrections: 4x USBLC6-2SC6 (one protects two lines), 4x MBR0530,
    220R in STOP_NC_OUT
    [common.py, load.py, mcu.py, power.py, safety.py, thermocouple.py, ui.py, usb.py]
2026-10-25 feat(hardware): controller netlist, BOM and checks (T017)
    - main.py: builds all blocks, ERC, checks GPIO nets against board_rev_a.h,
    writes controller.net and output/controller-bom.csv
    - tools/netlist_check.py: loads the netlist with KiCad 10 pcbnew
    (115 footprints, all pins have pads)
    - Fixed designators J1-J7, J9, TP1-TP11 as in contracts/connectors.md
    [controller-bom.csv]
2026-10-25 feat(hardware): encoder carrier schematic and netlist (T018)
    - Alps EC11E15244G1, IDC 2x4 (same pinout as controller J4), JST-XH 1x4 for the stop button
    - ERC clean, netlist loads in KiCad 10, pinout checked against controller J4
2026-10-25 feat(hardware): KiCad 10 project and design rules for controller (T019)
    - controller.kicad_pro: net classes Mains / Power / Default, manufacturing minimums
    - controller.kicad_dru: mains to low voltage 6 mm clearance and creepage, L-N 3 mm,
    no vias in mains, 3 mm to board edge and mounting holes; verified on a test board
    - empty 2-layer 1.6 mm board, project fp-lib-table, generator scripts
    [controller.kicad_pcb]
2026-10-25 feat(hardware): netlist import and initial placement for controller (T020, partial)
    - tools/import_netlist.py: update board from SKiDL netlist (matched by symbol path)
    - tools/place_controller.py: outline 100x100 mm, 4x M3 NPTH, slot under IRM-10-5,
    zone-based initial placement; refuses to run on a board with an outline
    - DRC: no clearance/creepage/drill violations; part-specific exceptions for the
    USB-C pitch (J7) and ESP32 thermal vias (U3)
    - Open: fine placement in KiCad, Omega socket measurement, mounting holes vs housing
    [controller.kicad_pcb]
2026-10-25 fix(hardware): hide BOM fields on silkscreen, turn J1/J2 to face the board edge
    - import_netlist.py sets MPN/Source/DNP fields invisible
    - J1 (mains) and J2 (load) rotated 180 deg, plug side flush with the edge
    - controller.kicad_pro: defaults added by KiCad 10 on first open
    [controller.kicad_pcb]
2026-10-25 feat(hardware): KiCad schematic becomes the source of truth (T071, part 1)
    - Schematic template generated once from SKiDL: controller (7 sheets) and encoder carrier
    - Verified SKiDL netlists frozen as controller.ref.net / encoder-carrier.ref.net
    - tools/check_schematic.py: compares the schematic with the reference (parts,
    connectivity, net names at the ESP32 and of net-class nets) and checks the GPIO
    assignment against board_rev_a.h; 0 errors for both boards
    - Generator defects fixed: ENC_B_RAW/ENC_SW_RAW shorted by overlapping wires,
    cp1252 MPN fields, missing labels BOOT, LED_DIAG, L_FUSED (lost net class Mains)
    - PCB relinked to the schematic symbols by reference, placement unchange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
    [controller-bom.csv, controller.kicad_pcb, controller.kicad_sch, controller_bedienung.kicad_sch, controller_last.kicad_sch, controller_mcu.kicad_sch, controller_netzteil.kicad_sch, controller_sicherheit.kicad_sch]
2026-10-26 feat(hardware): MAX31856 input filter per datasheet, sheet cleanup in progress
    - Input filter per MAX31856 "Typical Application Circuit": C14/C17 100 nF
    differential, new C27-C30 10 nF from T+/T- to GND; reference netlist re-exported
    - Datasheet checks: BIAS to T- confirmed, FAULT is push-pull (diodes to CLR needed)
    - check_schematic.py: sheet format check (raw newline in strings breaks KiCad)
    - import_netlist.py: relinks by reference when a symbol gets a new UUID (U7 case)
    - Sheets partly rearranged in KiCad by the user (connectivity unchanged, 0 errors)
    - MAX31856 order number and price, docs/Component-Specs ignored
    [controller.kicad_pcb, controller.kicad_sch, controller_bedienung.kicad_sch, controller_last.kicad_sch, controller_mcu.kicad_sch, controller_netzteil.kicad_sch, controller_sicherheit.kicad_sch, controller_thermoelemente.kicad_sch]
2026-10-26 refactor(hardware): merge the 7 controller sheets into 2 (T071)
    "Leistung und Sicherheit" (A3: Netzteil, Sicherheit, Last) and
    "Steuerung und Messung" (A2: MCU, USB, Thermoelemente, Bedienung).
    Contents are only moved, not rewired; each former sheet gets a labelled
    frame. check_schematic: 119 parts, 69 nets, 0 errors; ERC unchanged.
    PCB relinked by reference, placement unchanged, parity DRC clean.
    [controller.kicad_pcb, controller.kicad_sch, controller_bedienung.kicad_sch, controller_last.kicad_sch, controller_leistung.kicad_sch, controller_mcu.kicad_sch, controller_netzteil.kicad_sch, controller_sicherheit.kicad_sch]
2026-10-26 docs(spec): board fan for feature 002 (FR-036 to FR-038, R18)
    Clarified spec: Noctua NF-A4x10 5V PWM in the housing wall blowing
    outside air over the board, PWM by PCB temperature (20 % up to 35 C,
    100 % at 50 C), tachometer monitoring with latching error E206.
    Plan: J10 fan header, PWM on GPIO 38 via BSS138 with 5 V pull-up
    (full speed without firmware), tach on GPIO 37 (PCNT), module cooling.
2026-10-26 docs(tasks): board fan tasks for feature 002 (T072-T081)
    Datasheet check, schematic J10 with BSS138 PWM stage and tach input,
    cooling module (fan curve, FanMonitor, E206), HAL for LEDC/PCNT and
    HIL tests; existing tasks extended for E206, constants, TP12, J10
    placement, ordering and housing handover.
2026-10-26 docs(spec): mains cover for feature 002 (FR-039, SC-010, R19)
    Clarified spec: printed PC top and bottom shell over all 230 V parts,
    1 mm test wire must not reach mains (IPXXD), plug of J1 inside with
    strain relief, polyamide M3 screws through copper-free holes >= 6 mm
    from mains copper, designed and accepted in this feature.
    Plan: shell geometry and fixings, footprint COV1 with keepouts and
    DRC rule, Fusion 360 model under hardware/controller/cover, probe and
    temperature checks in quickstart.
2026-10-26 docs(tasks): mains cover tasks for feature 002 (T082-T086)
    Dimension check, footprint COV1 with keepouts and DRC rule for the
    cover holes, placement, Fusion 360 shells against the board STEP, print
    and probe-wire acceptance before mains operation; existing tasks
    extended for heights, review, ordering, lead trimming and housing.
2026-10-26 feat(hardware): board fan circuit in the schematic (T073), sheet cleanup in progress
    Fan header J10 with BSS138 PWM stage (GPIO 38, 1k pull-up to 5 V,
    full speed without firmware) and tachometer input (GPIO 37, 10k/1k/1n,
    TP12) per research R18. Reference netlist re-exported for this
    deliberate change: 129 parts, 73 nets. board_rev_a.h and
    check_schematic.py know FAN_TACH/FAN_PWM. PCB updated from the netlist,
    new footprints parked below the outline; parity DRC clean.
    Includes the user's partial sheet cleanup (T071 still open).
    [controller.kicad_pcb, controller.kicad_sch, controller_leistung.kicad_sch, controller_steuerung.kicad_sch]
2026-10-26 feat(hardware): mains cover footprint COV1 and datasheet checks (T072, T082, T083)
    - T072: fan max 0.35 W / 0.07 A, -10..+70 C; Molex 47053-1000 >= 75 C;
    GPIO 37/38 have no power-up glitch.
    - T082: heights under the cover <= 21.5 mm (IRM-10-5), cable 5.7-7.2 mm,
    PC-FR filament candidates.
    - T083: generated board-only footprint oven:Netzabdeckung_REVA (shell
    outline, no-footprint rule areas under the inner wall and flanges,
    NPTH H5-H8, sleeves H1/H3) and DRC rule cover_holes_to_mains.
    - Fix: hole_clearance is not checked for NPTH holes in KiCad 10.0.3;
    mains_to_mounting_holes and cover_holes_to_mains now use
    physical_hole_clearance (tested on a board copy).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
    [make_cover_footprint.py]
2026-10-27 feat(hardware): sheet cleanup done, ERC clean (T071)
    - Leistung/Steuerung sheets cleaned up and readable, intersheet references on
    - embedded symbols updated from the libraries (lib_symbol_mismatch gone)
    - stray and off-grid wire stubs removed
    - PWR_FLAGs on N_IN, L_FUSED, +5V and VBUS
    - ERC exclusion for the shared SDO line of U5/U6 (MAX31856, tristate)
    - PCB nets re-imported, U7 relinked
    kicad-cli ERC: 0 violations, check_schematic: 0 errors, parity DRC clean.
    [controller.kicad_pcb, controller_leistung.kicad_sch, controller_steuerung.kicad_sch]
2026-10-27 feat(hardware): mains cover COV1 placed on the board (T084)
    - COV1 at the board origin; H8 moved inside the cover below the IRM-10-5
    (boss on the right wall), outside its flange would block J5/J6
    - J2, U2, U9, J5, J6 shifted clear of wall and flange keepouts
    - thermocouple block regrouped around U5/U6 incl. input filters C27-C30
    - J10 at the top edge between ESP32 module and USB-C (J7 +4 mm),
    fan circuit placed below the USB parts
    DRC with schematic parity: no violations, only unconnected items and
    4 silk edge warnings; check_schematic 0 errors.
    [controller.kicad_pcb]
2026-10-27 feat(hardware): thermocouple sockets J5/J6 switched to RS PRO 381-7564
    - Omega PCC-SMP-K (46 EUR per 5-pack, dimensions only from an isometric
    drawing) replaced by RS PRO 381-7564 (type K IEC, NiCr/Ni contacts,
    about 5 EUR each, dimensioned drawing in the RS datasheet)
    - new footprint oven:RS_381-7564_Horizontal: 2 pins at 7.9 mm, NPTH 2.7 mm
    for an M2.5 screw; polarity still to be checked on a sample
    - schematic fields footprint/MPN/source, controller.ref.net re-exported
    (intended change; it also takes over the net names after the label
    cleanup, connectivity unchanged)
    - J5/J6 swapped on the board, pins below U5/U6, 2.7 mm gap between them
    - small part placement optimised for rout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
    [controller.kicad_pcb, controller_leistung.kicad_sch, controller_steuerung.kicad_sch]
2026-10-27 feat(hardware): controller REV A routed except 10 GND islands (T021)
    - mains copper routed by hand (top, 1 mm, locked); RV1 turned by 180
    degrees so N runs along the left edge and L on the right without
    crossing; 6 mm to low voltage, 3 mm L-N, 3 mm to edge, 6 mm to H5/H6
    - GND zones top and bottom over the low-voltage area, stitching vias on
    a 3 mm grid, SMD pads solid, THT pads with thermal relief
    - signals routed with Freerouting 1.9.0, +5V_PSU and TFT_RST by script
    - net class USB (VBUS, USB_DP/DN, CC1/2: 0.25 mm, 0.15 mm clearance)
    for the 0.85 mm pad pitch of J7, board minimum clearance 0.15 mm;
    same in make_project.py
    - silkscreen: 230 V warning, L/N, project name, REV A, pin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
    [controller.kicad_pcb]
2026-10-29 feat(hardware): JST XH connectors, re-placement and re-route, open fuse holder (T087, T021)
    Connectors (T087, research R9/R10, contracts/connectors.md):
    - J3 display JST XH 1x10 (same pin order as the IDC 2x5)
    - J4 encoder JST XH 1x5 (A, GND, B, SW, GND), new J11 stop button
    JST XH 1x4 directly on the main board; an unplugged stop connector
    opens the NC loop like a pressed stop button
    - encoder carrier: J1 JST XH 1x5, J2 (stop wires) removed
    - schematic wire chains of the old connectors replaced by labels,
    connectivity checked pin by pin; ref netlists re-exported
    Layout:
    - XH connectors at the right edge, RESET/BOOT moved inside
    - decoupling capacitors next to their IC pins (LDO 2.6/2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
    [controller.kicad_pcb, controller_leistung.kicad_sch, controller_steuerung.kicad_sch, encoder-carrier_encoder.kicad_sch]
2026-10-30 feat(hardware): test point groups labelled, TP11 removed, USB shield option R9 DNP
    - TP11 (second GND test point) removed, TP1 GND / TP2 3V3 / TP3 5V in a
    new order (user); contracts/connectors.md and controller.ref.net updated
    - top silkscreen groups: Versorgung (TP1-3), Freigabe (TP4-6),
    SSR (TP7-9), Last-Relais; test point signal names next to the pads
    - small layout optimisations; a GND via under TP4 (short to LATCH_Q) and
    a loose GND via removed, Q3 source re-connected to GND
    - USB shield: R9 (0 ohm) marked DNP, shield to GND via R8 1M || C11 4.7n
    - editor default pad size in the project file (user)
    DRC with schematic parity: 0 errors, 0 unconnected (2 silk edge
    warnings from the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
    [controller.kicad_pcb, controller_leistung.kicad_sch, controller_steuerung.kicad_sch]
2026-10-30 feat(hardware): references renumbered, fixed screw terminals J1/J2, 3D models ESP32/IRM-10
    - References re-annotated by sheet position; docs, specs, firmware comment,
    check_schematic.py and DRC rule esp32_thermal_vias (U3 -> U9) updated,
    reference netlist re-exported
    - Power symbols no longer excluded from simulation
    - J1/J2: Phoenix MKDS 1,5/2-5,08 and MKDS 1/6-3,81 instead of pluggable
    MSTBA/MC; own footprints keep the oval pads (3 mm L-N), generated by
    make_terminal_footprints.py
    - 3D models for U9 (Espressif) and U2 (Mean Well) in hardware/lib/3dmodels
    [controller.kicad_pcb, controller_leistung.kicad_sch, controller_steuerung.kicad_sch]
2026-10-30 feat(hardware): copper balancing in mains area, 3D model of thermocouple sockets
    - N_IN fill on both layers left of the slot and GND under the secondary
    side of the IRM-10-5 (Aisler hint on uneven copper distribution);
    coverage F.Cu 54 -> 66 %, B.Cu 58 -> 75 %, DRC unchanged
    - Simplified VRML model of RS PRO 381-7564 (J8, J10), generated by
    make_tc_socket_model.py and referenced in the footprint
    [controller.kicad_pcb]
2026-10-30 feat(hardware): manual layout refinements on controller REV A
    [controller.kicad_pcb]
